femtoduino/bomu-hardware/bomu/bomu.jpg

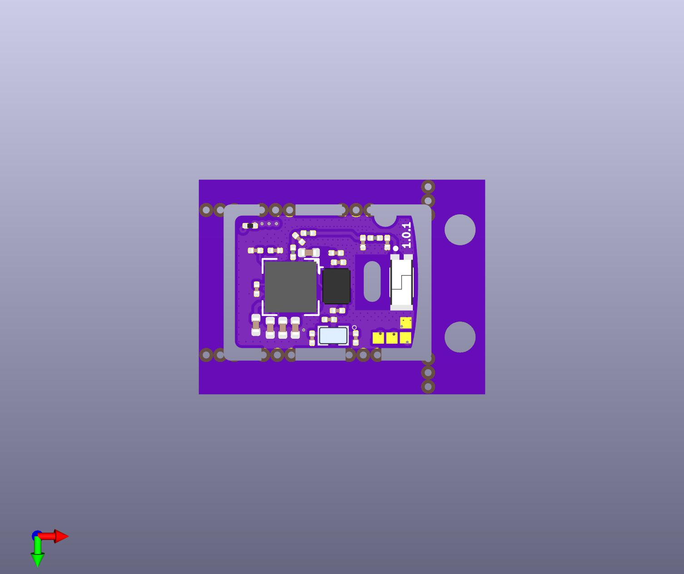
bomu/bomu.jpg
