femtoduino/bomu-hardware/bomu/bomu-bottom.png

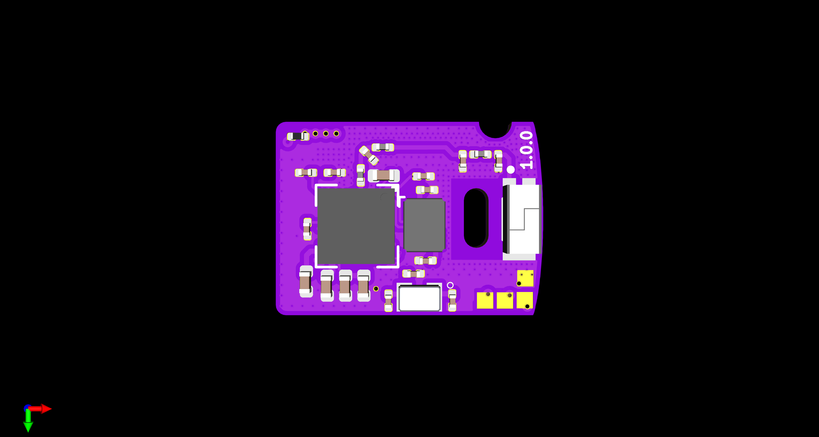
bomu/bomu-bottom.png
