femtoduino/bomu-hardware/bomu/bomu-render.png

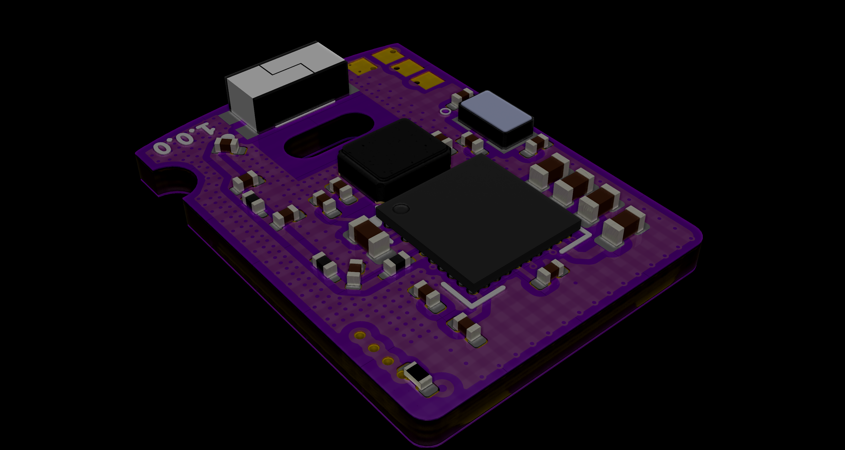
bomu/bomu-render.png
