femtoduino/bomu-hardware/3d/blender3d/prog-jig.stl

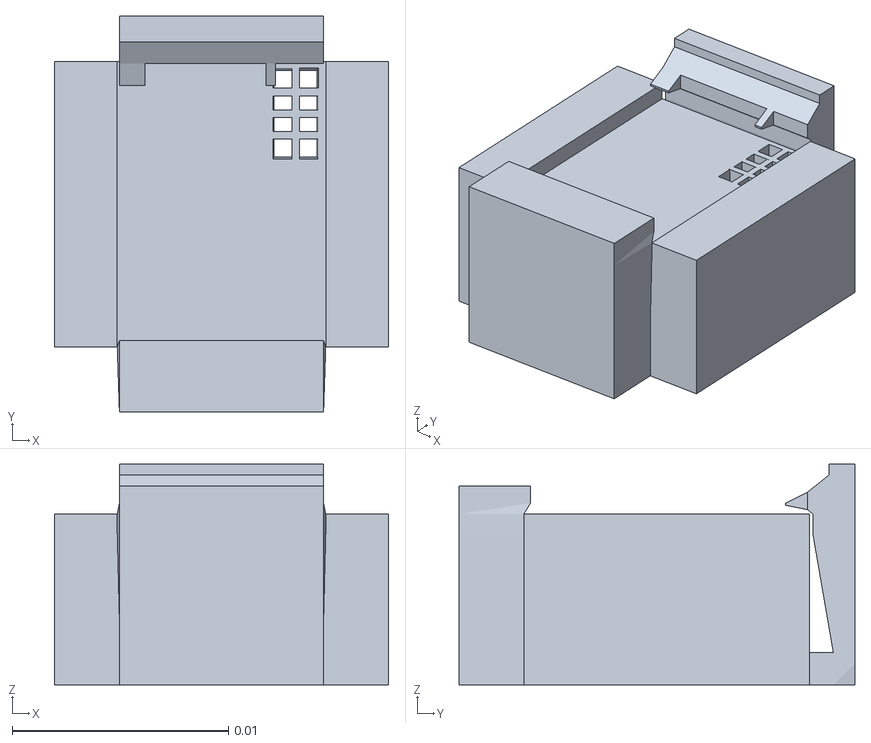
[picture p4: CAD file, 2021-12-15]
3d/blender3d/prog-jig.stl
0.0154 x 0.0183 x 0.0102
