femtoduino/bomu-hardware/bomu/bomu.step

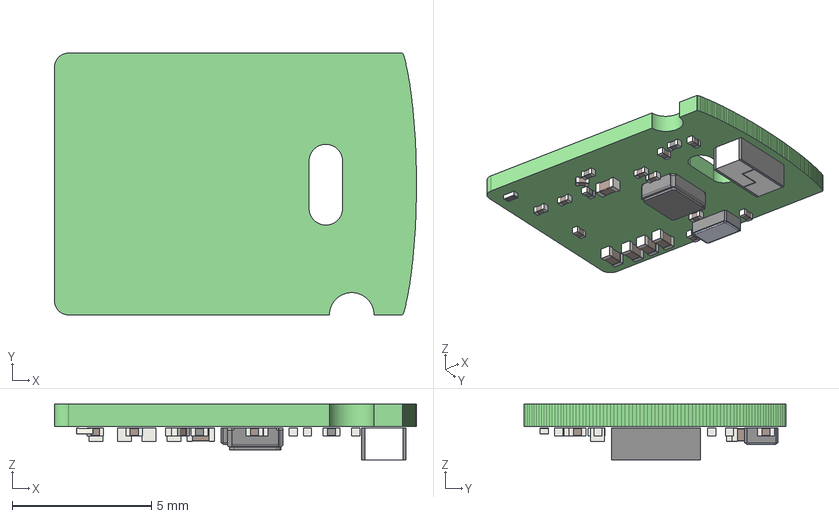
[picture p5: CAD file, 2021-12-15]
bomu/bomu.step
13.0 x 9.40 x 2.00 mm
nrf52840-ckaa-r7
