femtoduino/bomu-hardware/3d/blender3d/prog-jig-v2.stl

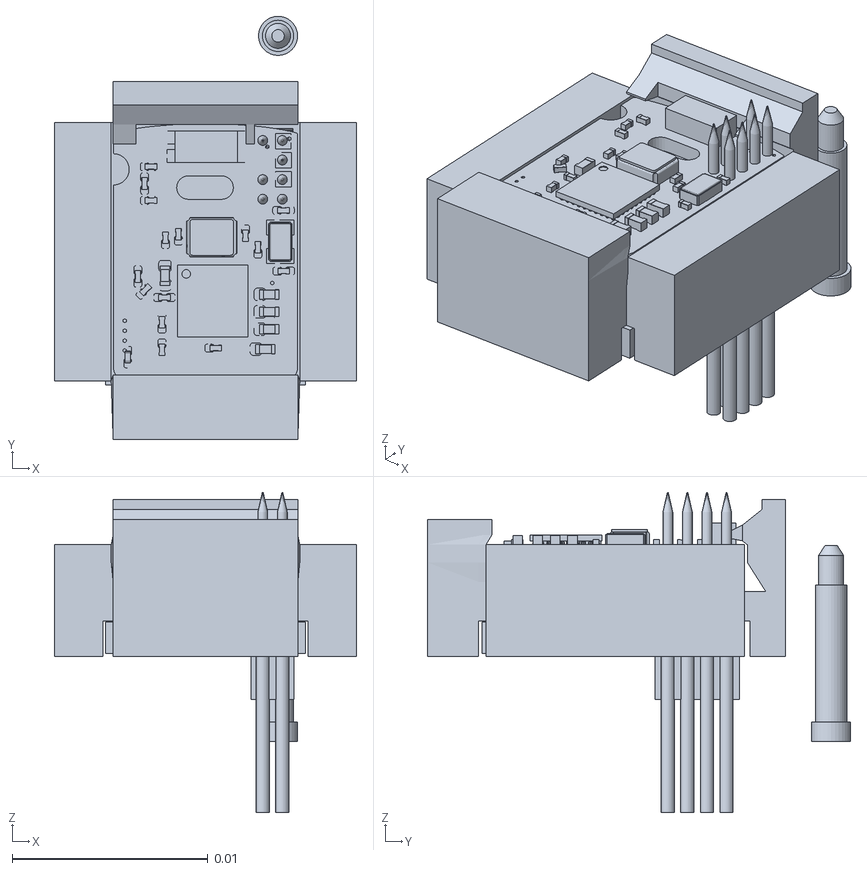
[picture p6: CAD file, 2021-12-15]
3d/blender3d/prog-jig-v2.stl
0.0154 x 0.0216 x 0.0163
