femtoduino/bomu-hardware/(list of files, cad)

Other CAD files:
bomu/bomu-export.stl
bomu/bomu-export.obj
bomu/bomu-export.ply
bomu/bomu.stl
