femtoduino/bomu-hardware/bomu-programmer/bomu-programmer/bomu-programmer.kicad_pcb

## KiCad design bomu-programmer/bomu-programmer/bomu-programmer.kicad_pcb (2023-04-04)

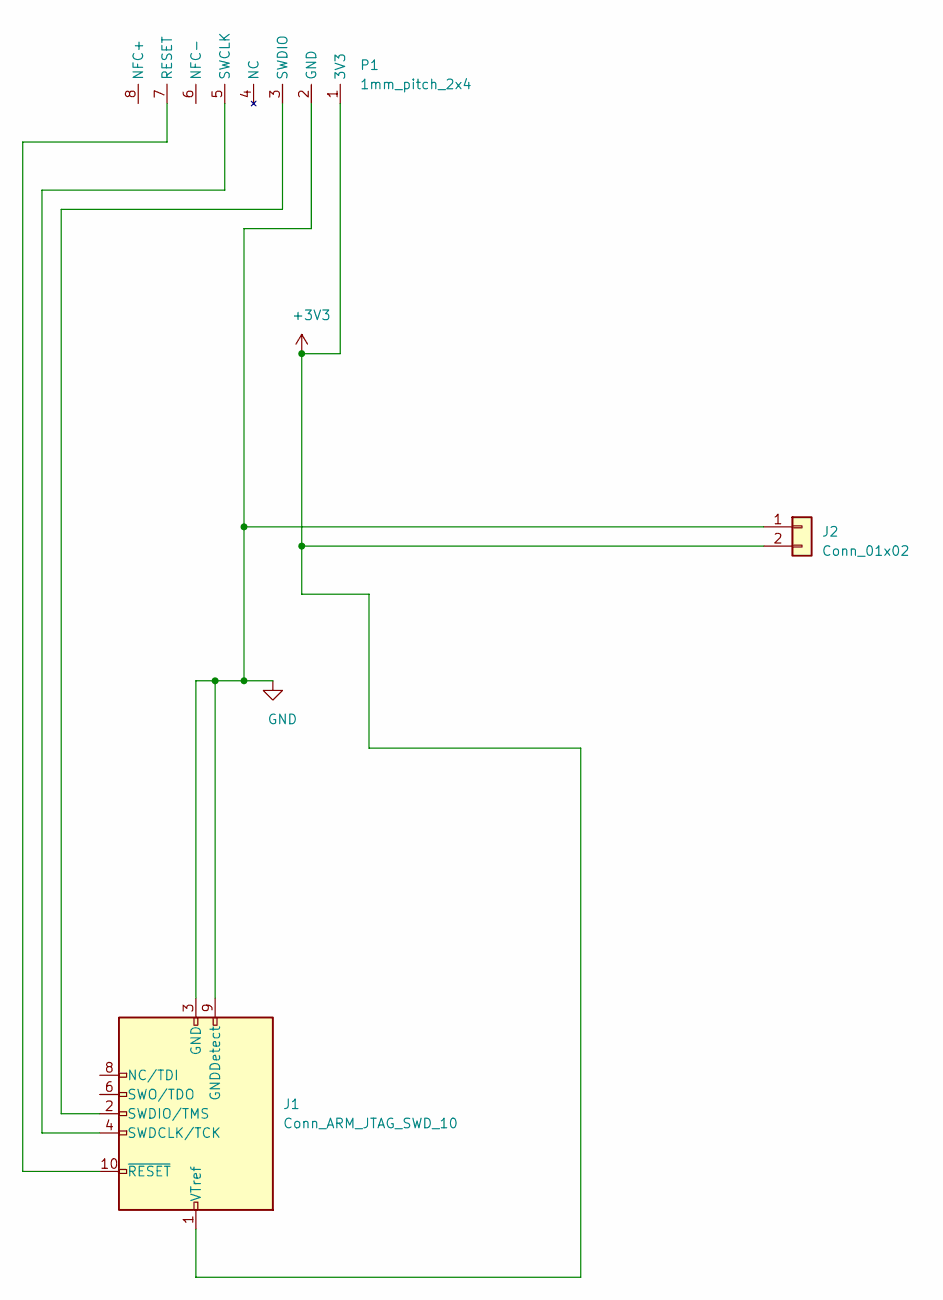
[picture p8: schematic bomu-programmer.kicad_sch]

Parts:
J1: Conn_ARM_JTAG_SWD_10; PinSocket_2x05_P1.27mm_Vertical_SMD
J2: Conn_01x02; PinHeader_1x02_P2.54mm_Vertical
P1: 1mm_pitch_2x4; pin_2x4_1mm

Connections:
+3V3: J1.1 (VTref), J2.2, P1.1 (3V3)
GND: J1.3 (GND), J1.5 (GND), J1.9 (GNDDetect), J2.1, P1.2 (GND)
unnamed: J1.4 (SWDCLK/TCK), P1.5 (SWCLK)
unnamed: J1.2 (SWDIO/TMS), P1.3 (SWDIO)
unnamed: J1.10 (~RESET), P1.7 (RESET)

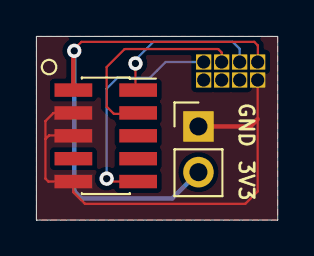
[picture p9: board bomu-programmer.kicad_pcb from above]

Board: 2 copper layers, 13.4 x 10.2 mm, 3 parts (0 on the bottom side), 5 nets.
