femtoduino/bomu-hardware/bomu/bomu.kicad_pcb

## KiCad design bomu/bomu.kicad_pcb (2023-03-18)

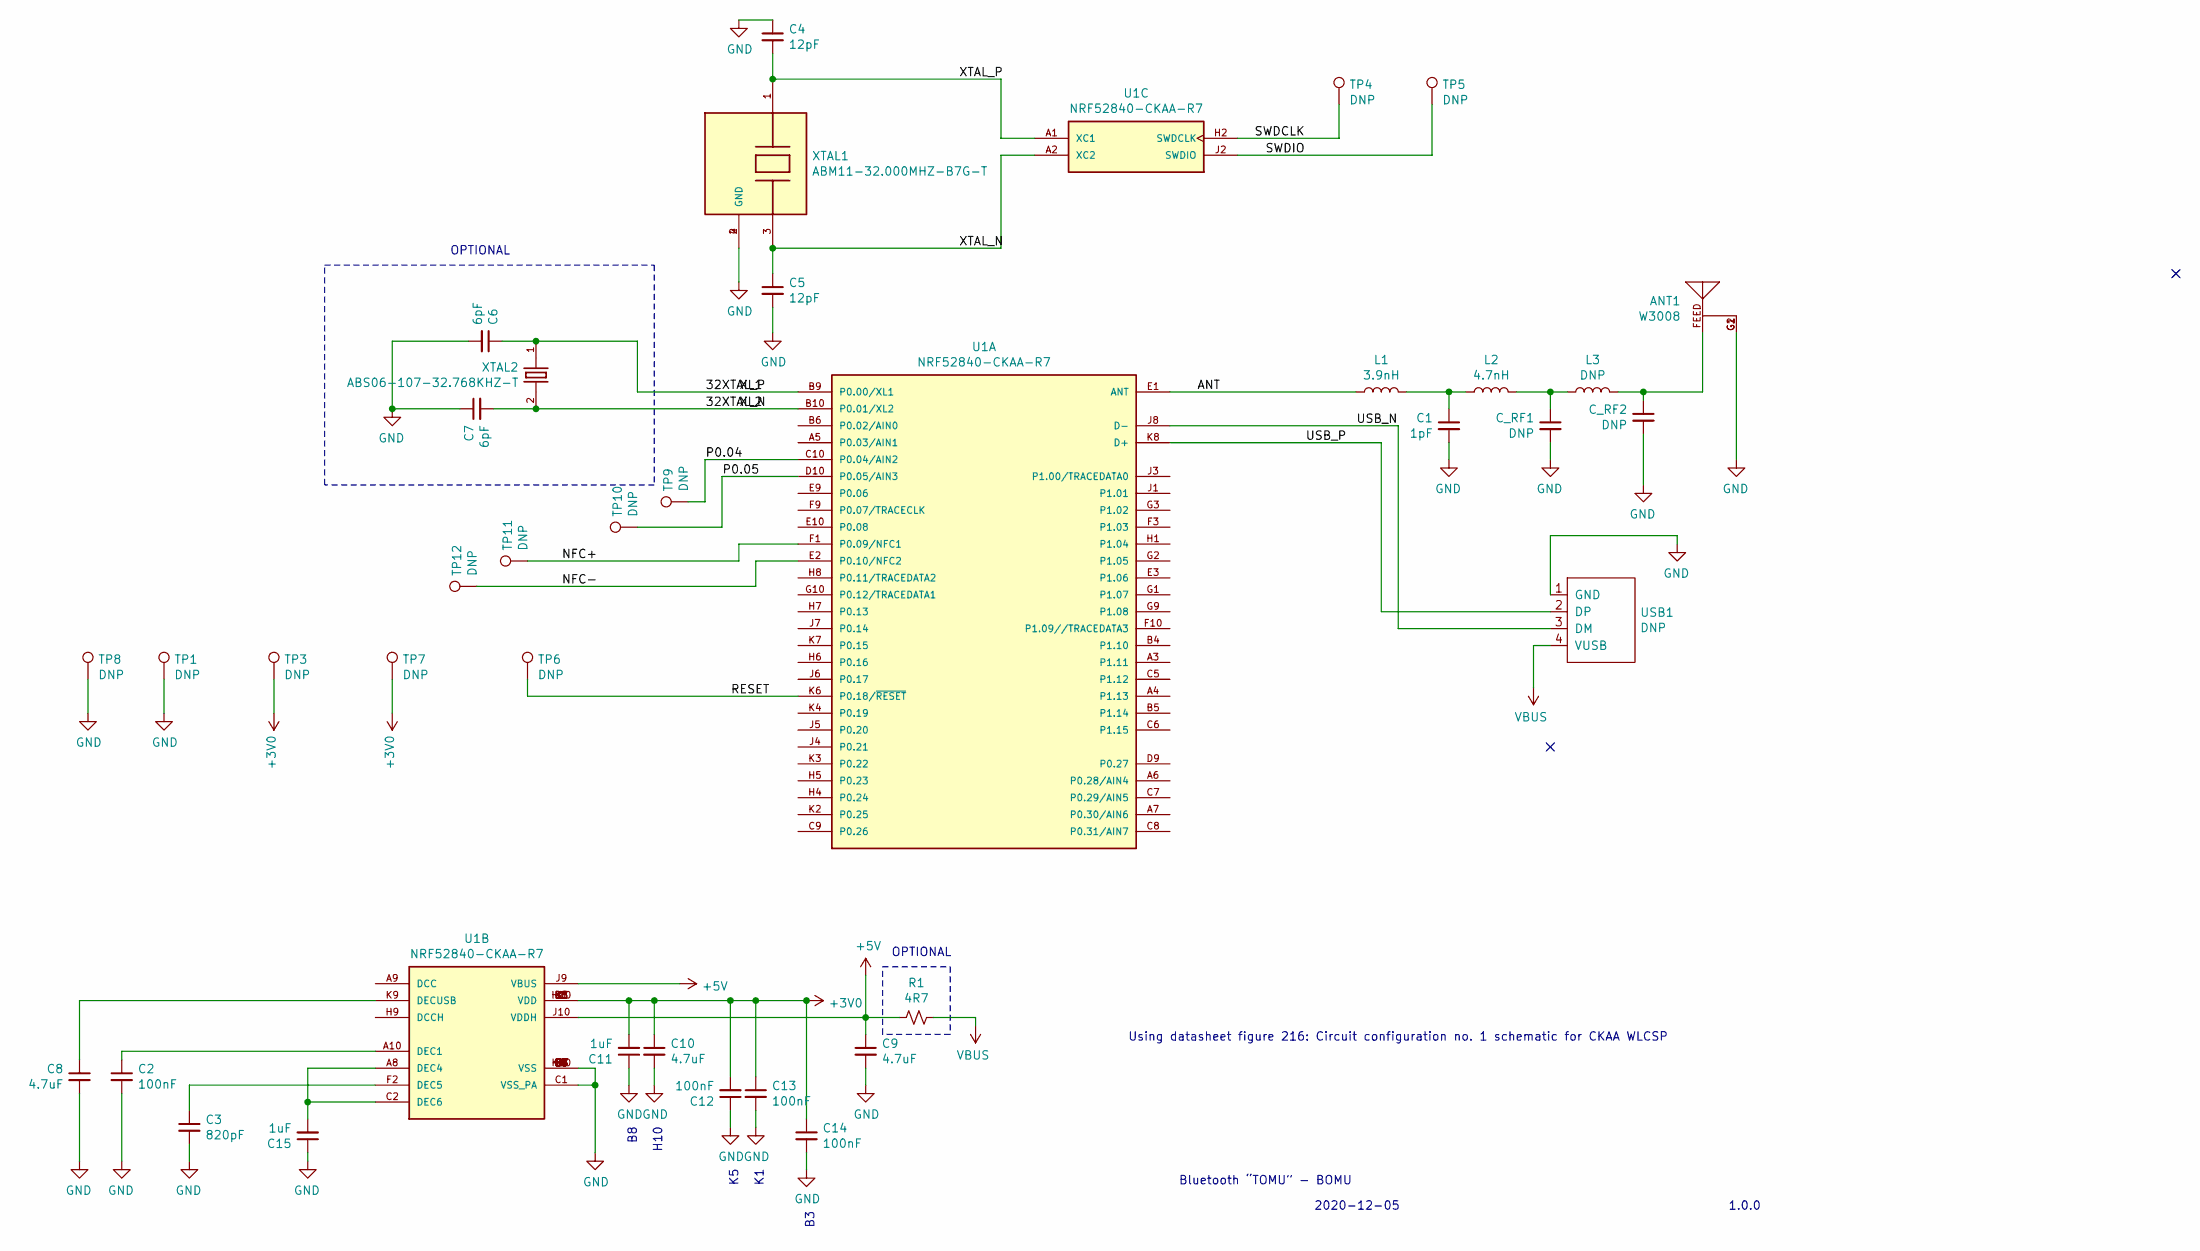
[picture p10: schematic bomu.kicad_sch]

Parts:
ANT1: W3008; ANTENNA_W3008
C1: 1pF; C_0201_0603Metric
C2, C12, C13, C14: 100nF; C_0201_0603Metric
C3: 820pF; C_0201_0603Metric
C4, C5: 12pF; C_0201_0603Metric
C6, C7: 6pF; C_0201_0603Metric
C8, C9, C10: 4.7uF; C_0402_1005Metric
C11, C15: 1uF; C_0402_1005Metric
C_RF1, C_RF2: DNP; C_0201_0603Metric
L1: 3.9nH; L_0201_0603Metric
L2: 4.7nH; L_0201_0603Metric
L3: DNP; L_0201_0603Metric
R1: 4R7; R_0201_0603Metric
TP1, TP3, TP4, TP5, TP6, TP7, TP8, TP9, TP10, TP11, TP12: DNP; TestPoint_Pad_D1.0mm
U1: NRF52840-CKAA-R7; BGA94N35P10X10_360X354X51N; PARTREV 1.1
USB1: DNP; USB_A_SOCKET_PCB_INSERT
XTAL1: ABM11-32.000MHZ-B7G-T; OSCCC200X160X59; DIGI-KEY_PART_NUMBER 535-10942-1-ND
XTAL2: ABS06-107-32.768KHZ-T; XTAL_ABS06-107-32.768KHZ-T

Connections:
+3V0: C10.1, C11.2, C12.2, C13.1, C14.1, TP3.1, TP7.1, U1.B3 (VDD), U1.B8 (VDD), U1.H10 (VDD), U1.K1 (VDD), U1.K5 (VDD)
+5V: C9.1, R1.2, U1.J9 (VBUS), U1.J10 (VDDH)
/32XTAL_N: C7.2, U1.B10 (P0.01/XL2), XTAL2.2
/32XTAL_P: C6.1, U1.B9 (P0.00/XL1), XTAL2.1
/ANT: L1.2, U1.E1 (ANT)
/NFC+: TP11.1, U1.F1 (P0.09/NFC1)
/NFC-: TP12.1, U1.E2 (P0.10/NFC2)
/P0.04: TP9.1, U1.C10 (P0.04/AIN2)
/P0.05: TP10.1, U1.D10 (P0.05/AIN3)
/RESET: TP6.1, U1.K6 (P0.18/~RESET)
/SWDCLK: TP4.1, U1.H2 (SWDCLK)
/SWDIO: TP5.1, U1.J2 (SWDIO)
/USB_N: U1.J8 (D-), USB1.3 (DM)
/USB_P: U1.K8 (D+), USB1.2 (DP)
/XTAL_N: C5.1, U1.A2 (XC2), XTAL1.3
/XTAL_P: C4.2, U1.A1 (XC1), XTAL1.1
GND: ANT1.G1, ANT1.G2, C1.2, C2.2, C3.2, C4.1, C5.2, C6.2, C7.1, C8.2, C9.2, C10.2, C11.1, C12.1, C13.2, C14.2, C15.1, C_RF1.2, C_RF2.2, TP1.1, TP8.1, U1.B7 (VSS), U1.C1 (VSS_PA), U1.C4 (VSS), U1.D3 (VSS), U1.D4 (VSS), U1.D5 (VSS), U1.D6 (VSS), U1.D7 (VSS), U1.D8 (VSS), U1.E4 (VSS), U1.E5 (VSS), U1.E6 (VSS), U1.E7 (VSS), U1.E8 (VSS), U1.F4 (VSS), U1.F5 (VSS), U1.F6 (VSS), U1.F7 (VSS), U1.F8 (VSS), U1.G4 (VSS), U1.G5 (VSS), U1.G6 (VSS), U1.G7 (VSS), U1.G8 (VSS), U1.K10 (VSS), USB1.1 (GND), XTAL1.2 (GND), XTAL1.4 (GND)
unnamed: ANT1.FEED, C_RF2.1, L3.1
unnamed: C1.1, L1.1, L2.2
unnamed: C_RF1.1, L2.1, L3.2
unnamed: C2.1, U1.A10 (DEC1)
unnamed: C15.2, U1.A8 (DEC4), U1.C2 (DEC6)
unnamed: C3.1, U1.F2 (DEC5)
unnamed: C8.1, U1.K9 (DECUSB)
VBUS: R1.1, USB1.4 (VUSB)

Notes on the sheet:
H10
OPTIONAL
1.0.0
2020-12-05
Bluetooth “TOMU” - BOMU
Using datasheet figure 216: Circuit configuration no. 1 schematic for CKAA WLCSP

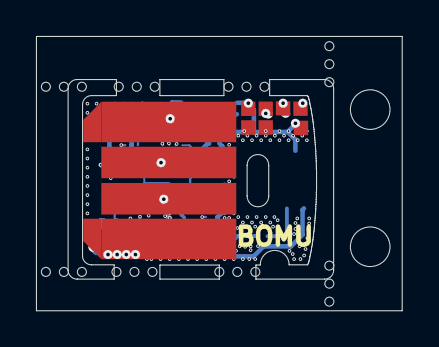
[picture p11: board bomu.kicad_pcb from above]

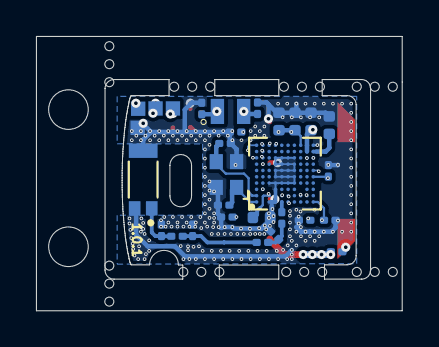
[picture p12: board bomu.kicad_pcb from below]

Board: 6 copper layers, 20.3 x 15.2 mm, 37 parts (29 on the bottom side), 25 nets.
