femtoduino/bomu-hardware/(commit log)

2020-12-05 LFS track PDF files
2020-12-06 Initial work on BOMU schematic. Will need to swap out QFN for WLCSP design instead
    [bomu.kicad_pcb, bomu.sch]
2020-12-06 Adding WLCSP footprint and symbol
2020-12-06 Swapped QFN for WLCSP
    [bomu.sch]
2020-12-06 Cleaning up schematic
    [bomu.sch]
2020-12-06 Added remaining components to schematic
    [bomu.sch]
2020-12-06 Adding USB symbol. Will need custom USB A tab footprint
    [bomu.sch]
2020-12-06 Updating schematic info
    [bomu.sch]
2020-12-06 Adding custom USB A tab insert symbol and footprint. Started work on PCB
    [bomu.kicad_pcb, bomu.sch]
2020-12-15 Current work on the PCB
    [bomu.kicad_pcb, bomu.sch]
2020-12-15 Changing from 2-lyaer to 4-layer
    [bomu.kicad_pcb]
2020-12-15 Updating footprints. Adding SWD pads
    [bomu.kicad_pcb, bomu.sch]
2020-12-15 Adjusting pour around antenna footprint. Adding more traces
    [bomu.kicad_pcb]
2020-12-23 Current work on ground planes
    [bomu.kicad_pcb, bomu.sch]
2020-12-23 Adding ground plane stitching with microvias
    [bomu.kicad_pcb]
2020-12-25 Current progress on BOMU 1.0.0
    [bomu.kicad_pcb, bomu.sch]
2020-12-27 Adding gerbers, and current work
    [bomu-B_Cu.gbl, bomu-B_Mask.gbs, bomu-B_Paste.gbp, bomu-B_SilkS.gbo, bomu-Edge_Cuts.gm1, bomu-F_Cu.gtl, bomu-F_Mask.gts, bomu-F_Paste.gtp]
2020-12-27 PCB design edits
    [bomu.kicad_pcb]
2021-01-03 Latest changes to the schematic and pcb
    [bomu.kicad_pcb, bomu.sch]
2021-01-06 Tonight's work on bomu. Added LC filter to VDD3P3 pins
    [bomu.kicad_pcb, bomu.sch]
2021-01-18 Latest work on BOMU design
    [bomu.kicad_pcb, bomu.sch]
2021-01-18 Adjusting 3D model paths for component 3D models. Adding gerbers
    [bomu-B_Cu.gbl, bomu-B_Mask.gbs, bomu-B_Paste.gbp, bomu-B_SilkS.gbo, bomu-Edge_Cuts.gm1, bomu-F_Cu.gtl, bomu-F_Mask.gts, bomu-F_Paste.gtp]
2021-01-21 Updating schematic KiCAD version. Updating antenna tuning component footprint placements
    [bomu.kicad_pcb, bomu.kicad_sch]
2021-01-21 Updating gerbers, drills, etc
    [bomu-B_Cu.gbl, bomu-B_Mask.gbs, bomu-B_Paste.gbp, bomu-B_Silkscreen.gbo, bomu-Edge_Cuts.gm1, bomu-F_Cu.gtl, bomu-F_Mask.gts, bomu-F_Paste.gtp]
2021-02-12 Added CPWG ground layer cutouts under RF component footprints
    [bomu-B_Cu.gbl, bomu-B_Mask.gbs, bomu-B_Paste.gbp, bomu-B_Silkscreen.gbo, bomu-Edge_Cuts.gm1, bomu-F_Cu.gtl, bomu-F_Mask.gts, bomu-F_Paste.gtp]
2021-12-15 Current work on BOMU 1.0.1, which address two known design defects in 1.0.0
    [bomu-B_Cu.gbl, bomu-B_Mask.gbs, bomu-B_Paste.gbp, bomu-B_SilkS.gbo, bomu-B_Silkscreen.gbo, bomu-Edge_Cuts.gm1, bomu-F_Cu.gtl, bomu-F_Mask.gts]
2021-12-18 Current work on BOMU 1.0.1 and gerber/drill outputs
    [bomu-B_Cu.gbl, bomu-B_Mask.gbs, bomu-B_Paste.gbp, bomu-B_Silkscreen.gbo, bomu-Edge_Cuts.gm1, bomu-F_Cu.gtl, bomu-F_Mask.gts, bomu-F_Paste.gtp]
2021-12-18 Adding BoM partslist to repository
2021-12-23 DRC violation corrections, regenerated gerbers, re-rendered 3D render as a JPEG
    [bomu-B_Cu.gbl, bomu-B_Mask.gbs, bomu-B_Paste.gbp, bomu-B_Silkscreen.gbo, bomu-Edge_Cuts.gm1, bomu-F_Cu.gtl, bomu-F_Mask.gts, bomu-F_Paste.gtp]
2021-12-23 Upgrading file format to KiCAD 6.0
    [bomu.kicad_sch]
2021-12-31 Updating to use the stable KiCAD 6.0 release, adjusting mouse_bites footprint
    [bomu.kicad_pcb]
2022-02-18 Addressing two (2) defects found in 1.0.0, reducing the amount of excess ground layer stitching, and addressing swapped USB data pins (corrected in 1.0.1)
    [bomu-B_Cu.gbl, bomu-B_Mask.gbs, bomu-B_Paste.gbp, bomu-B_Silkscreen.gbo, bomu-Edge_Cuts.gm1, bomu-F_Cu.gtl, bomu-F_Mask.gts, bomu-F_Paste.gtp]
2022-02-19 Adjusting a ground trace from the antenna, regenerated gerber files, adding layer stackup txt file
    [bomu-B_Cu.gbl, bomu-B_Mask.gbs, bomu-B_Paste.gbp, bomu-B_Silkscreen.gbo, bomu-Edge_Cuts.gm1, bomu-F_Cu.gtl, bomu-F_Mask.gts, bomu-F_Paste.gtp]
2023-03-18 Upgrading for KiCAD 7.x format. Adding PDF of bomu-programmer PCB
    [bomu-programmer.kicad_pcb, bomu-programmer.kicad_sch, bomu.kicad_pcb, bomu.kicad_sch]
2023-04-04 Updating for KiCAD 7. Updated bomu-programmer board. Gerbers for bomu-programmer generated.
    [bomu-programmer-B_Cu.gbl, bomu-programmer-B_Mask.gbs, bomu-programmer-B_Paste.gbp, bomu-programmer-B_Silkscreen.gbo, bomu-programmer-Edge_Cuts.gm1, bomu-programmer-F_Cu.gtl, bomu-programmer-F_Mask.gts, bomu-programmer-F_Paste.gtp]
